TinyTapeout/breakout-pcb/breakout-dip-gf/breakout-dip-gf.kicad_pcb

## KiCad design breakout-dip-gf/breakout-dip-gf.kicad_pcb (2026-09-19)

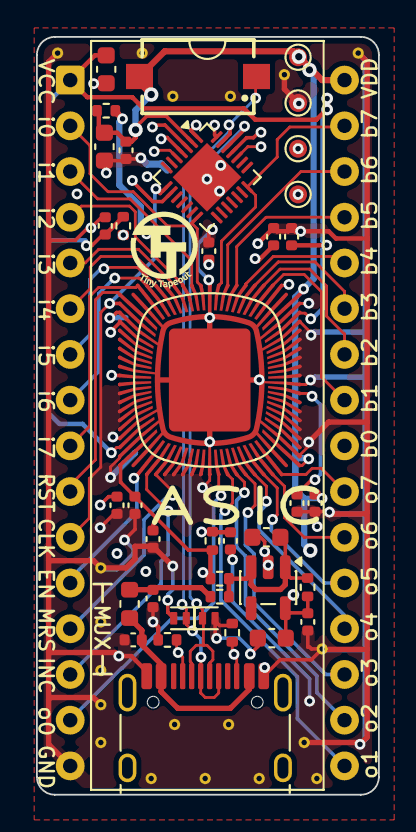
[picture p1: board breakout-dip-gf.kicad_pcb from above]

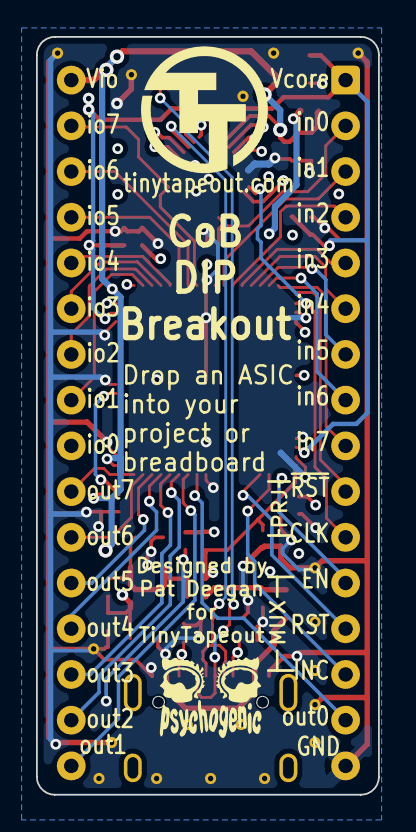
[picture p2: board breakout-dip-gf.kicad_pcb from below]

Board: 4 copper layers, 19.0 x 42.1 mm, 61 parts (2 on the bottom side), 43 nets.

Parts:
C1, C2: 1uF; C_0402_1005Metric
C3: DIP-32_W15.24mm
C4, C5, C17, C19: 10u; C_0603_1608Metric
C6, C14, C15, C16: 100nF; C_0402_1005Metric
C7, C8, C9, C10, C11, C12, C13, C18: 1u; C_0402_1005Metric
D1, D2: 5VTVS; D_SOD-882
FB1: 120R; L_0603_1608Metric
J1: USB_C; USB_C_Receptacle_HRO_TYPE-C-31-M-12
PsyLogo002: PsychoLogoMicroC
R1, R2: 5.1k; R_0402_1005Metric
R3, R4, R5, R6, R7, R8: 0; R_0402_1005Metric
STITCH01, STITCH2, STITCH2#2, STITCH2#3, STITCH2#4, STITCH2#5, STITCH2#6, STITCH2#7, STITCH2#8, STITCH2#9, STITCH2#10, STITCH2#11, STITCH2#12, STITCH2#13, STITCH3, STITCH4, STITCH5, STITCH5#2, STITCH5#3: StitchingVia-0.3mm
SW1: 434121025816
TP1, TP2, TP4, TP5: TestPoint; TestPoint_Pad_D1.0mm
TTLOGO01: TT_PMOD_Logo_5mm
TTLOGO1: TT_logo
U1: TT_GF_COB; ttgf0p2_cob
U2: CH32X035G8U6; WQFN-28-1EP_4x4mm_P0.4mm_EP2.7x2.7mm
U3: AP2112K-3.3; SOT-23-5

Connections:
/CC1: J1.A5 (CC1), R2.1, U2.28 (CC1)
/CC2: J1.B5 (CC2), R1.1, U2.1 (CC2)
/CH32DCK: TP5.1 (1_1), U2.24 (DCK)
/CH32DIO: TP4.1 (1_1), U2.25 (DIO)
/VDIN: C4.1, R3.1, R7.2, R8.2, U3.1 (VIN), U3.3 (EN)
/enable: C3.12, U1.1 (ctrl_ena), U2.3 (PC0)
/increment: C3.14, U1.2 (ctrl_sel_inc), U2.5 (PA0)
/p_clk: C3.11, U1.56 (u_clk), U2.8 (RX2)
/rst_n: C3.13, U1.3 (ctrl_sel_rst_n), U2.4 (PC3)
/uin0: C3.2, U1.47 (ui[0]), U2.14 (PB3)
/uin1: C3.3, U1.48 (ui[1])
/uin2: C3.4, U1.49 (ui[2])
/uin3: C3.5, U1.50 (ui[3])
/uin4: C3.6, U1.51 (ui[4])
/uin5: C3.7, U1.52 (ui[5])
/uin6: C3.8, U1.53 (ui[6])
/uin7: C3.9, U1.54 (ui[7])
/uio0: C3.24, U1.38 (uio[0])
/uio1: C3.25, U1.39 (uio[1])
/uio2: C3.26, U1.40 (uio[2])
/uio3: C3.27, U1.41 (uio[3])
/uio4: C3.28, U1.42 (uio[4])
/uio5: C3.29, U1.43 (uio[5])
/uio6: C3.30, U1.44 (uio[6])
/uio7: C3.31, U1.45 (uio[7]), U2.21 (PB10)
/uout0: C3.15, U1.10 (uo[0])
/uout1: C3.17, U1.11 (uo[1])
/uout2: C3.18, U1.12 (uo[2])
/uout3: C3.19, U1.13 (uo[3])
/uout4: C3.20, U1.14 (uo[4])
/uout5: C3.21, U1.15 (uo[5])
/uout6: C3.22, U1.16 (uo[6])
/uout7: C3.23, U1.17 (uo[7])
/~p_rst: C3.10, U1.55 (u_rst_n), U2.9 (PA4)
GND: C1.2, C2.2, C3.16 (GND), C4.2, C5.2, C6.2, C7.2, C8.2, C9.2, C10.2, C11.2, C12.2, C13.2, C14.2, C15.2, C16.2, C17.2, C18.2, C19.2, D1.2 (A2), D2.2 (A2), J1.A1 (GND), J1.A12 (GND), J1.B1 (GND), J1.B12 (GND), R1.2, R2.2, STITCH01.1, STITCH2.1, STITCH2#2.1, STITCH2#3.1, STITCH2#4.1, STITCH2#5.1, STITCH2#6.1, STITCH2#7.1, STITCH2#8.1, STITCH2#9.1, STITCH2#10.1, STITCH2#11.1, STITCH2#12.1, STITCH2#13.1, STITCH3.1, STITCH4.1, STITCH5.1, STITCH5#2.1, STITCH5#3.1, TP1.1 (1_1), U1.9 (GND_IO), U1.19 (GND_IO), U1.27 (GND_Analog), U1.34 (GND_Core), U1.36 (GND_IO), U1.46 (GND_IO), U1.57 (GND_IO), U1.63 (GND_Analog), U1.71 (GND_Core), U1.73 (GND_IO), U1.75 (SUB), U2.29 (GND), U3.2 (GND)
VAA: C12.1, C13.1, R6.2, U1.26 (VAA_Analog), U1.64 (VAA_Analog)
VBUS: C2.1, FB1.2, R7.1
VBUSRW: C1.1, FB1.1, J1.A4 (VBUS), J1.A9 (VBUS), J1.B4 (VBUS), J1.B9 (VBUS)
VDD_{CORE}: C3.1 (VCORE), C10.1, C11.1, C15.1, C17.1, R4.2, R6.1, U1.35 (VDD_Core), U1.72 (VDD_Core)
VDD_{IO}: C3.32 (VIO), C7.1, C8.1, C9.1, C14.1, C16.1, C18.1, C19.1, R4.1, R5.2, R8.1, SW1.2, TP2.1 (1_1), U1.18 (VDD_IO), U1.37 (VDD_IO), U1.58 (VDD_IO), U1.74 (VDD_IO), U2.2 (VDD)
VIO_{REG}: C5.1, C6.1, R3.2, R5.1, U3.5 (VOUT)
usb_d+: D2.1 (A1), J1.A6 (D+), J1.B6 (D+), SW1.1, U2.27 (UDP)
usb_d-: D1.1 (A1), J1.A7 (D-), J1.B7 (D-), U2.26 (UDM)
