TinyTapeout/breakout-pcb/breakout-sky-qfn/breakout-sky-qfn.kicad_pcb

## KiCad design breakout-sky-qfn/breakout-sky-qfn.kicad_pcb (2025-09-11)

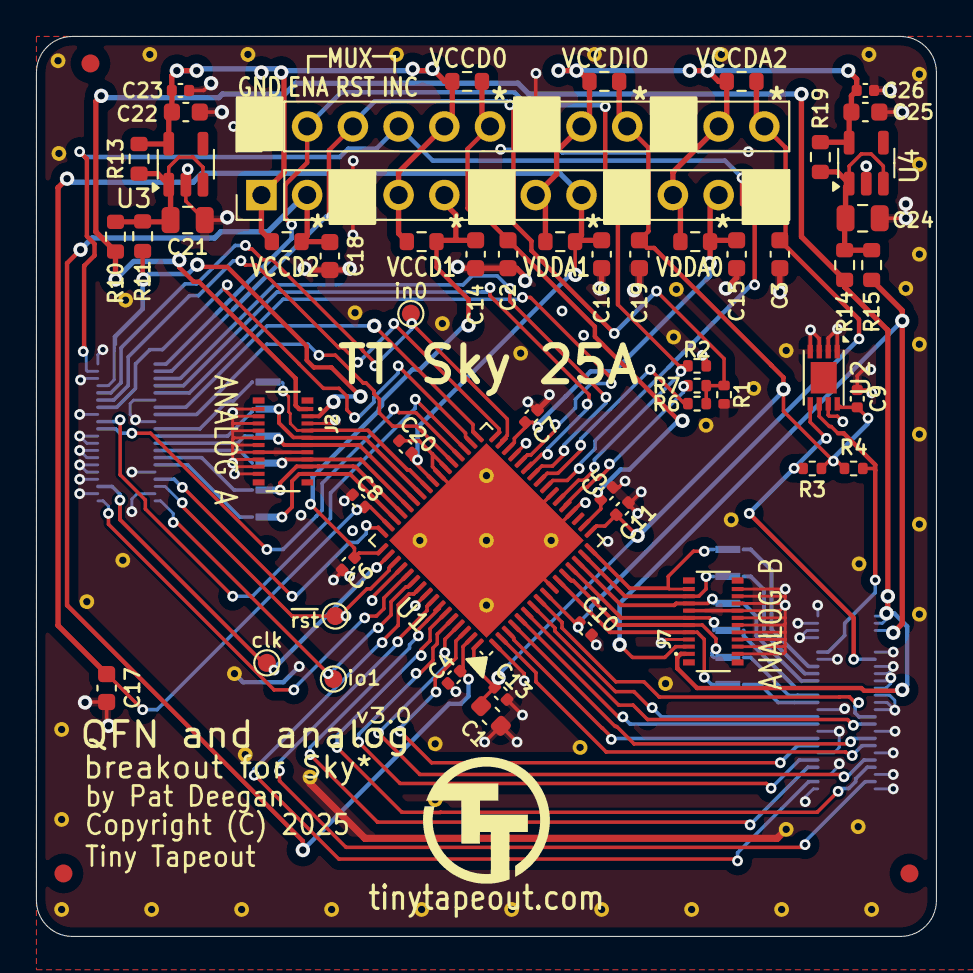
[picture p3: board breakout-sky-qfn.kicad_pcb from above]

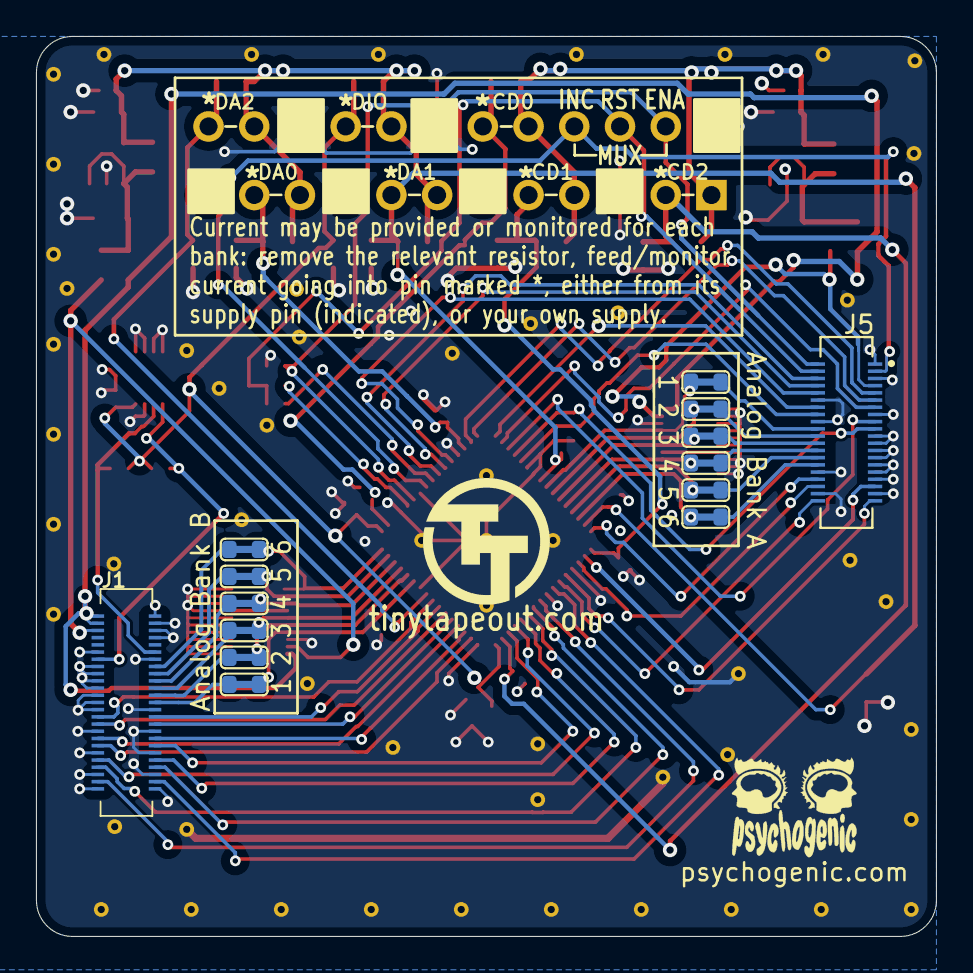
[picture p4: board breakout-sky-qfn.kicad_pcb from below]

Board: 4 copper layers, 50.0 x 50.0 mm, 130 parts (15 on the bottom side), 74 nets.

Parts:
C1, C2, C3, C14, C15, C16, C17, C18, C19: C_1u_0603_50V; C_0603_1608Metric
C4, C5, C6, C7, C8, C9, C10, C11, C13, C20: 0.1uf; C_0402_1005Metric
C21, C24: 10uF; C_0805_2012Metric
C22, C25: 1uF; C_0603_1608Metric
C23, C26: 100nF; C_0402_1005Metric
FID1, FID2, FID3: Fiducial; Fiducial_1mm_Mask2mm
J1: DF40C-50DS-0.4V_51; HRS_DF40C-50DS-0.4V_51
J2, J7: DF40C-20DS-0.4V_51; HRS_DF40C-20DP-0.4V_51
J3, J4: Conn_01x12; PinHeader_1x12_P2.54mm_Vertical
J5: DF40C-40DS-0.4V_51; HIROSE_DF40C-40DS-0.4V_51
JP1, JP2, JP3, JP4, JP5, JP6, JP7, JP8, JP9, JP10, JP11, JP12: Jumper_2_Small_Bridged; SolderJumper-2_0603
R1, R2: 1k; R_0402_1005Metric
R3, R4: 2k; R_0402_1005Metric
R5, R8, R9, R10, R11, R12, R13, R14, R15, R16, R17, R18, R19: 0; R_0603_1608Metric
R6, R7: 0R; R_0402_1005Metric
STITCH01, STITCH01#2, STITCH01#3, STITCH01#4, STITCH01#5, STITCH01#6, STITCH01#7, STITCH01#8, STITCH01#9, STITCH01#10, STITCH01#11, STITCH01#12, STITCH01#13, STITCH01#14, STITCH01#15, STITCH01#16, STITCH01#17, STITCH01#18, STITCH01#19, STITCH01#20, STITCH01#21, STITCH01#22, STITCH01#23, STITCH01#24, STITCH01#25, STITCH01#26, STITCH01#27, STITCH01#28, STITCH01#29, STITCH01#30, STITCH01#31, STITCH01#32, STITCH01#33, STITCH01#34, STITCH01#35, STITCH2, STITCH3, STITCH4, STITCH5, STITCH6, STITCH7, STITCH8, STITCH9, STITCH10, STITCH11, STITCH12, STITCH13, STITCH14, STITCH14#2, STITCH15, STITCH16, STITCH17, STITCH18, STITCH19, STITCH20: StitchingVia-0.4mmDrill
TP5, TP6, TP7, TP8: TestPoint; TestPoint_Pad_D1.0mm
TTLOGO1, TTLOGO1#2: TT_logo
U1: Openframe_QFN_TT06_REV2; QFN-64-1EP_9x9mm_P0.5mm_EP7.65x7.65mm
U2: 24LC02; DFN-8-1EP_3x2mm_P0.5mm_EP1.75x1.45mm
U3, U4: AP2112K-1.8; SOT-23-5

Connections:
+3V3: J1.5, J2.3, J5.8, J7.3, R11.1, R15.1
+5V: J1.1, J1.3, J2.1, J7.1, R10.1, R14.1
/CS_SCL: J1.12, R4.2, U2.6 (SCL)
/RES1: J5.5, U1.26 (reserved)
/RES2: J5.7, U1.27 (reserved)
/RES3: J5.9, U1.28 (reserved)
/RX_SDA: J1.13, R3.2, U2.5 (SDA)
/VCIN: C21.1, R10.2, R11.2, R13.1, U3.1 (VIN), U3.3 (EN)
/VDIN: C24.1, R14.2, R15.2, R19.1, U4.1 (VIN), U4.3 (EN)
/c_ena: J4.2, J5.1, R2.1, U1.22 (ctrl_ena)
/c_rst_n: R6.2, U1.25 (ctrl_sel_rst_n)
/c_sel_inc: J4.4, J5.4, U1.24 (ctrl_sel_inc)
/chip_an0: J2.7, JP1.1 (A), U1.41 (analog[0])
/chip_an1: J2.9, JP2.1 (A), U1.42 (analog[1])
/chip_an2: J2.11, JP3.1 (A), U1.43 (analog[2])
/chip_an3: J2.15, JP4.1 (A), U1.44 (analog[3])
/chip_an4: J2.17, JP5.1 (A), U1.45 (analog[4])
/chip_an5: J2.19, JP6.1 (A), U1.46 (analog[5])
/chip_an6: J7.7, JP7.1 (A), U1.11 (analog[6])
/chip_an7: J7.9, JP8.1 (A), U1.12 (analog[7])
/chip_an8: J7.11, JP9.1 (A), U1.13 (analog[8])
/chip_an9: J7.15, JP10.1 (A), U1.14 (analog[9])
/chip_an10: J7.17, JP11.1 (A), U1.15 (analog[10])
/chip_an11: J7.19, JP12.1 (A), U1.16 (analog[11])
/hd_an0: J5.19, JP1.2 (B)
/hd_an1: J5.21, JP2.2 (B)
/hd_an2: J5.23, JP3.2 (B)
/hd_an3: J5.25, JP4.2 (B)
/hd_an4: J5.27, JP5.2 (B)
/hd_an5: J5.29, JP6.2 (B)
/hd_an6: J1.26, JP7.2 (B)
/hd_an7: J1.24, JP8.2 (B)
/hd_an8: J1.22, JP9.2 (B)
/hd_an9: J1.20, JP10.2 (B)
/hd_an10: J1.18, JP11.2 (B)
/hd_an11: J1.16, JP12.2 (B)
/hd_c_rst_n: J4.3, J5.3, R1.1, R6.1, R7.1
/p_clk: J5.36, TP6.1, U1.50 (clk)
/p_rst: J5.35, TP7.1, U1.51 (rst_n)
/reset_b: R7.2, U1.21 (resetb)
/uin0: J5.10, TP5.1, U1.31 (ui_in[0])
/uin1: J5.12, U1.32 (ui_in[1])
/uin2: J5.13, U1.33 (ui_in[2])
/uin3: J5.14, U1.34 (ui_in[3])
/uin4: J5.18, U1.35 (ui_in[4])
/uin5: J5.20, U1.36 (ui_in[5])
/uin6: J5.15, U1.37 (ui_in[6])
/uin7: J5.33, U1.48 (ui_in[7])
/uio0: J5.40, U1.53 (uio[0])
/uio1: J5.39, TP8.1, U1.54 (uio[1])
/uio2: J1.48, U1.55 (uio[2])
/uio3: J1.47, U1.57 (uio[3])
/uio4: J1.44, U1.58 (uio[4])
/uio5: J1.43, U1.59 (uio[5])
/uio6: J1.42, U1.60 (uio[6])
/uio7: J1.41, U1.61 (uio[7])
/uout0: J1.38, U1.62 (uo_out[0])
/uout1: J1.37, U1.2 (uo_out[1])
/uout2: J1.36, U1.3 (uo_out[2])
/uout3: J1.35, U1.4 (uo_out[3])
/uout4: J1.32, U1.5 (uo_out[4])
/uout5: J1.31, U1.6 (uo_out[5])
/uout6: J1.30, U1.7 (uo_out[6])
/uout7: J1.29, U1.8 (uo_out[7])
GND: C1.2, C2.2, C3.2, C4.1, C5.1, C6.2, C7.1, C8.1, C9.1, C10.2, C11.2, C13.1, C14.2, C15.2, C16.2, C17.2, C18.2, C19.2, C20.1, C21.2, C22.2, C23.2, C24.2, C25.2, C26.2, J1.2, J1.4, J1.6, J1.8, J1.11, J1.14, J1.15, J1.17, J1.19, J1.21, J1.23, J1.25, J1.27, J1.28, J1.33, J1.34, J1.39, J1.40, J1.45, J1.46, J1.49, J1.50, J2.2, J2.4, J2.5, J2.6, J2.8, J2.10, J2.12, J2.13, J2.14, J2.16, J2.18, J2.20, J3.3, J3.6, J3.9, J3.12, J4.1, J4.7, J4.10, J5.2, J5.6, J5.11, J5.16, J5.17, J5.22, J5.24, J5.26, J5.28, J5.30, J5.31, J5.32, J5.34, J5.37, J5.38, J7.2, J7.4, J7.5, J7.6, J7.8, J7.10, J7.12, J7.13, J7.14, J7.16, J7.18, J7.20, R1.2, R2.2, STITCH01.1, STITCH01#2.1, STITCH01#3.1, STITCH01#4.1, STITCH01#5.1, STITCH01#6.1, STITCH01#7.1, STITCH01#8.1, STITCH01#9.1, STITCH01#10.1, STITCH01#11.1, STITCH01#12.1, STITCH01#13.1, STITCH01#14.1, STITCH01#15.1, STITCH01#16.1, STITCH01#17.1, STITCH01#18.1, STITCH01#19.1, STITCH01#20.1, STITCH01#21.1, STITCH01#22.1, STITCH01#23.1, STITCH01#24.1, STITCH01#25.1, STITCH01#26.1, STITCH01#27.1, STITCH01#28.1, STITCH01#29.1, STITCH01#30.1, STITCH01#31.1, STITCH01#32.1, STITCH01#33.1, STITCH01#34.1, STITCH01#35.1, STITCH2.1, STITCH3.1, STITCH4.1, STITCH5.1, STITCH6.1, STITCH7.1, STITCH8.1, STITCH9.1, STITCH10.1, STITCH11.1, STITCH12.1, STITCH13.1, STITCH14.1, STITCH14#2.1, STITCH15.1, STITCH16.1, STITCH17.1, STITCH18.1, STITCH19.1, STITCH20.1, U1.1 (vssa2), U1.10 (vssd2), U1.20 (vssa), U1.23 (vssd), U1.29 (vssio), U1.38 (vssa1), U1.39 (vssd1), U1.52 (vssa1), U1.56 (vssio), U1.65 (ThermalPad), U2.1 (A0), U2.2 (A1), U2.3 (A2), U2.4 (GND), U2.7 (WP), U3.2 (GND), U4.2 (GND)
VCCD_{0}: C2.1, C5.2, J4.6, R16.2, U1.18 (vccd)
VCCD_{1}: C6.1, C14.1, J3.5, R8.2, U1.49 (vccd1)
VCCD_{2}: C4.2, C18.1, J3.2, R5.2, U1.63 (vccd2)
VCC_{REG}: C22.1, C23.1, J3.1, J3.4, J4.5, R5.1, R8.1, R13.2, R16.1, U3.5 (VOUT)
VDDA_{0}: C7.2, C15.1, J3.11, R9.2, U1.30 (vdda)
VDDA_{1}: C8.2, C16.1, C17.1, C20.2, J3.8, R17.2, U1.40 (vdda1), U1.47 (vdda1)
VDDA_{2}: C3.1, C10.1, J4.12, R18.2, U1.9 (vdda2)
VDD_{IO}: C1.1, C9.2, C11.1, C13.2, C19.1, J4.9, R3.1, R4.1, R12.2, U1.17 (vddio), U1.64 (vddio), U2.8 (VCC)
VDD_{REG}: C25.1, C26.1, J3.7, J3.10, J4.8, J4.11, R9.1, R12.1, R17.1, R18.1, R19.2, U4.5 (VOUT)
