TinyTapeout/breakout-pcb/ASIC-simulator/tt04-fpga-ICE40UP5k/breakout-fpga-ICE40UP5K.kicad_pcb

## KiCad design ASIC-simulator/tt04-fpga-ICE40UP5k/breakout-fpga-ICE40UP5K.kicad_pcb (2024-04-16)

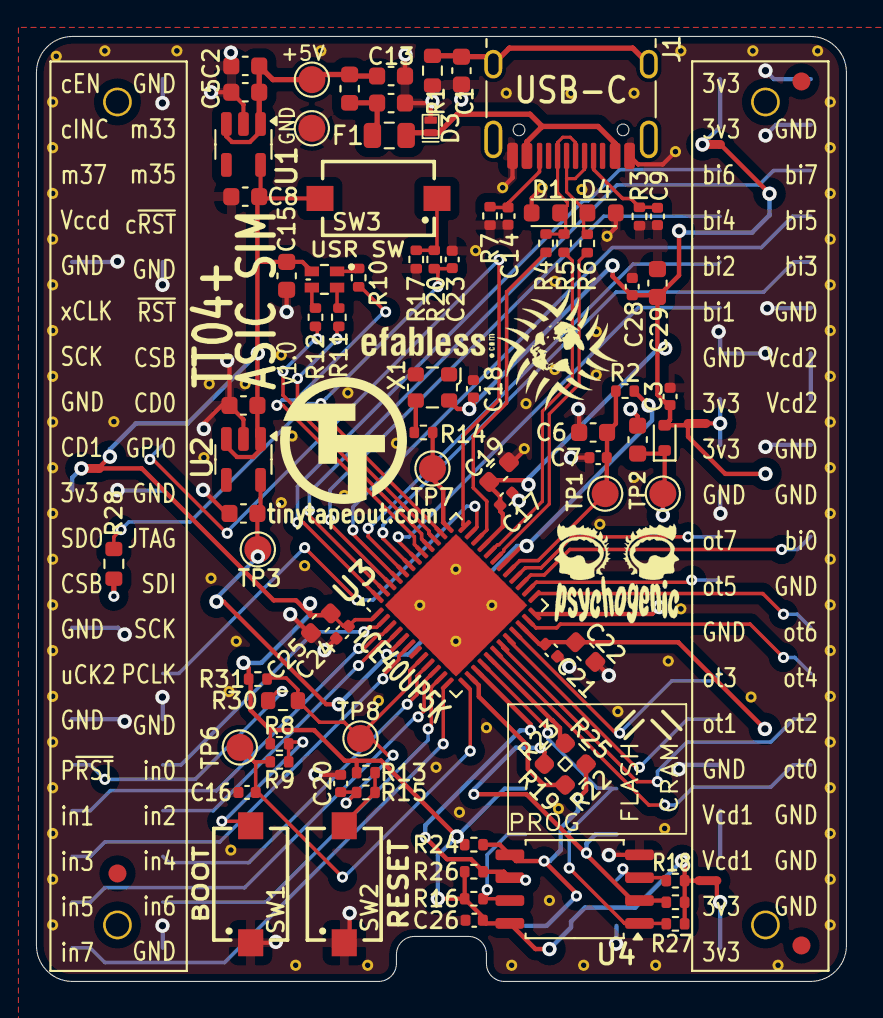
[picture p5: board breakout-fpga-ICE40UP5K.kicad_pcb from above]

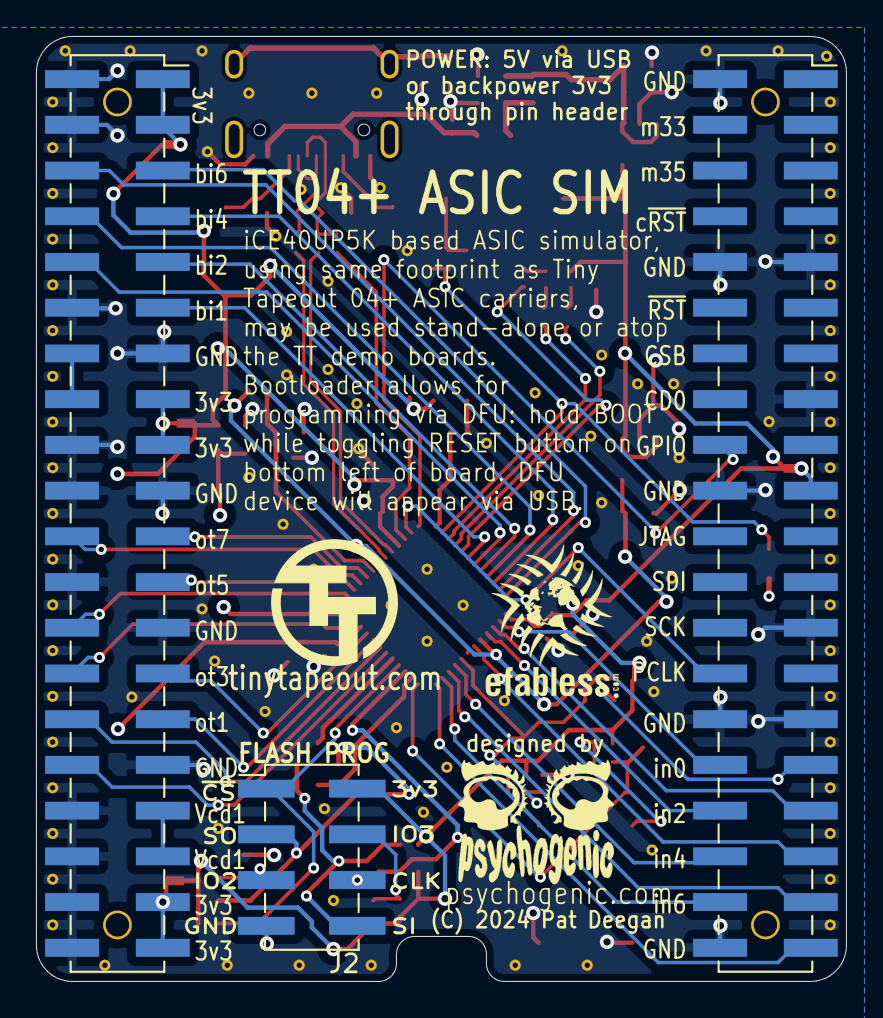
[picture p6: board breakout-fpga-ICE40UP5K.kicad_pcb from below]

Board: 4 copper layers, 45.0 x 52.5 mm, 191 parts (3 on the bottom side), 71 nets.

Parts:
C1: CUSBSHIELD; C_0603_1608Metric
C2, C4, C5, C8, C11, C12, C13: C_1u_0603_50V; C_0603_1608Metric
C3, C7, C16, C17, C18, C20, C21, C23, C24, C26, C28: C_100n_0402_50V; C_0402_1005Metric
C6, C10, C15, C19, C22, C25, C29: C_4p7u_0603_25V; C_0603_1608Metric
C9, C14: C_330p_0402_50V; C_0402_1005Metric
CON1, CON2: FH-00148_PinSocket_2x20_P2.54mm
D1, D4: TVS; D_0603_1608Metric
D2: 1N4448WT; D_SOD-523
D3: VBUSTVS; DFN1006-2
D5: RGB; LED_EAST1616RGBA3
F1: 350mA; Fuse_0805_2012Metric
FB1: 120R; L_0603_1608Metric
FID1, FID2, FID3: Fiducial; Fiducial_1mm_Mask2mm
J1: USB_C; USB_C_Receptacle_HRO_TYPE-C-31-M-12
J2: Conn_02x04_Odd_Even; PinHeader_2x04_P2.54mm_Vertical_SMD
NT1, NT2, NT3, NT4: NetTie_2; NetTie-2_SMD_Pad0.5mm
R1: R_1M_0603; R_0603_1608Metric
R2, R10, R14: R_100R_0402; R_0402_1005Metric
R3, R7: R_5k1_0402; R_0402_1005Metric
R4, R9, R15, R20: R_1k5_0402; R_0402_1005Metric
R5, R6, R11, R12: R_68R_0402; R_0402_1005Metric
R8, R13, R16, R17, R18, R21, R24, R26, R27, R31: R_10k_0402; R_0402_1005Metric
R19, R22, R23, R25, R28, R30: R_0R_0603_JUMPER; R_0603_1608Metric
STITCH1, STITCH1#2, STITCH1#3, STITCH1#4, STITCH1#5, STITCH1#6, STITCH1#7, STITCH1#8, STITCH1#9, STITCH1#10, STITCH1#11, STITCH1#12, STITCH1#13, STITCH1#14, STITCH1#15, STITCH1#16, STITCH1#17, STITCH1#18, STITCH1#19, STITCH1#20, STITCH1#21, STITCH1#22, STITCH1#23, STITCH1#24, STITCH1#25, STITCH1#26, STITCH1#27, STITCH1#28, STITCH1#29, STITCH1#30, STITCH1#31, STITCH1#32, STITCH1#33, STITCH1#34, STITCH1#35, STITCH1#36, STITCH1#37, STITCH1#38, STITCH1#39, STITCH1#40, STITCH1#41, STITCH1#42, STITCH1#43, STITCH1#44, STITCH2, STITCH3, STITCH4, STITCH5, STITCH6, STITCH7, STITCH8, STITCH9, STITCH10, STITCH11, STITCH12, STITCH13, STITCH14, STITCH15, STITCH17, STITCH18, STITCH19, STITCH20, STITCH21, STITCH22, STITCH23, STITCH24, STITCH25, STITCH26, STITCH27, STITCH28, STITCH29, STITCH30, STITCH31, STITCH32, STITCH33, STITCH34, STITCH35, STITCH36, STITCH37, STITCH38, STITCH39, STITCH40, STITCH43, STITCH44, STITCH46, STITCH47, STITCH48, STITCH50, STITCH51, STITCH52, STITCH54, STITCH59, STITCH60, STITCH61, STITCH62, STITCH62#2, STITCH62#3, STITCH62#4, STITCH62#5: StitchingVia-0.3mm
SW1, SW2, SW3: 434121025816
TP1, TP2, TP3, TP4, TP5, TP6, TP7, TP8: TestPoint; TestPoint_Pad_D1.5mm
U1: AP2112K-3.3; SOT-23-5
U2: AP2112K-1.2; SOT-23-5
U3: ICE40UP5K-SG48ITR; QFN-48-1EP_7x7mm_P0.5mm_EP5.6x5.6mm
U4: W25Q32JVSS; SOIC-8_5.23x5.23mm_P1.27mm
X1: 24MHz; Oscillator_SMD_ECS_2520MV-xxx-xx-4Pin_2.5x2.0mm

Connections:
+1V2: C11.1, R2.1, TP3.1, U2.5 (VOUT), U3.5 (VCC), U3.30 (VCC)
+2V5: C10.1, D2.1 (K), TP2.1, U3.24 (VPP_2V5)
+3V3: C3.1, C4.1, C8.1, C15.1, C17.1, C18.1, C19.1, C21.1, C22.1, C24.1, C25.1, C26.1, C28.1, C29.1, D2.2 (A), D5.4, J2.2, NT1.2, NT2.2, NT3.2, NT4.2, R8.1, R13.1, R16.1, R18.1, R21.1, R24.1, R26.1, R27.1, R31.1, SW3.2, U1.5 (VOUT), U2.1 (VIN), U2.3 (EN), U3.1 (VCCIO_2), U3.22 (SPI_VCCIO1), U3.33 (VCCIO_0), U4.8 (VCC), X1.4 (VDD)
+5V: C2.1, C5.1, C13.1, FB1.2, TP4.1, U1.1 (VIN), U1.3 (EN)
/CC1: C9.1, J1.A5 (CC1), R3.1
/CC2: C14.1, J1.B5 (CC2), R7.1
/FL_MISO: J2.3, R19.1, R21.2, R23.1, U4.2 (DO(IO1))
/FL_MOSI: J2.8, R22.2, R24.2, R25.2, U4.5 (DI(IO0))
/FPGA_SI: R23.2, R25.1, U3.17 (IOB_33b_SPI_SI)
/FPGA_SO: R19.2, R22.1, U3.14 (IOB_32a_SPI_SO)
/IOT_44B: R4.1, U3.34 (IOT_44b)
/LED_B: R12.2, U3.40 (RGB1)
/LED_G: R11.2, U3.39 (RGB0)
/LED_R: R10.2, U3.41 (RGB2)
/VCC_PLL: C6.1, C7.1, R2.2, TP1.1, U3.29 (VCCPLL)
/fl_io2: J2.5, R18.2, U4.3 (IO2)
/fl_io3: J2.4, R16.2, U4.7 (IO3)
/oscclk: R14.1, X1.3 (OUT)
/spi_clk: J2.6, R26.2, U3.15 (IOB_34a_SPI_SCK), U4.6 (CLK)
/vbus: D3.1 (K), F1.1, J1.A4 (VBUS), J1.A9 (VBUS), J1.B4 (VBUS), J1.B9 (VBUS)
/vbusfused: C12.1, F1.2, FB1.1
/~FLCS: J2.1, R27.2, U3.16 (IOB_35b_SPI_SS), U4.1 (~CS)
BOOT: C16.1, R9.2, TP6.1, U3.13 (IOB_24a)
GND: C1.2, C2.2, C3.2, C4.2, C5.2, C6.2, C7.2, C8.2, C9.2, C10.2, C11.2, C12.2, C13.2, C14.2, C15.2, C16.2, C17.2, C18.2, C19.2, C20.2, C21.2, C22.2, C23.2, C24.2, C25.2, C26.2, C28.2, C29.2, CON1.2, CON1.9, CON1.10, CON1.15, CON1.20, CON1.25, CON1.29, CON1.30, CON1.40, CON2.2, CON2.4, CON2.12, CON2.13, CON2.18, CON2.19, CON2.20, CON2.24, CON2.25, CON2.31, CON2.34, CON2.36, CON2.38, CON2.40, D1.2 (A2), D3.2 (A), D4.2 (A2), J1.A1 (GND), J1.A12 (GND), J1.B1 (GND), J1.B12 (GND), J2.7, R1.2, R3.2, R7.2, R17.2, STITCH1.1, STITCH1#2.1, STITCH1#3.1, STITCH1#4.1, STITCH1#5.1, STITCH1#6.1, STITCH1#7.1, STITCH1#8.1, STITCH1#9.1, STITCH1#10.1, STITCH1#11.1, STITCH1#12.1, STITCH1#13.1, STITCH1#14.1, STITCH1#15.1, STITCH1#16.1, STITCH1#17.1, STITCH1#18.1, STITCH1#19.1, STITCH1#20.1, STITCH1#21.1, STITCH1#22.1, STITCH1#23.1, STITCH1#24.1, STITCH1#25.1, STITCH1#26.1, STITCH1#27.1, STITCH1#28.1, STITCH1#29.1, STITCH1#30.1, STITCH1#31.1, STITCH1#32.1, STITCH1#33.1, STITCH1#34.1, STITCH1#35.1, STITCH1#36.1, STITCH1#37.1, STITCH1#38.1, STITCH1#39.1, STITCH1#40.1, STITCH1#41.1, STITCH1#42.1, STITCH1#43.1, STITCH1#44.1, STITCH2.1, STITCH3.1, STITCH4.1, STITCH5.1, STITCH6.1, STITCH7.1, STITCH8.1, STITCH9.1, STITCH10.1, STITCH11.1, STITCH12.1, STITCH13.1, STITCH14.1, STITCH15.1, STITCH17.1, STITCH18.1, STITCH19.1, STITCH20.1, STITCH21.1, STITCH22.1, STITCH23.1, STITCH24.1, STITCH25.1, STITCH26.1, STITCH27.1, STITCH28.1, STITCH29.1, STITCH30.1, STITCH31.1, STITCH32.1, STITCH33.1, STITCH34.1, STITCH35.1, STITCH36.1, STITCH37.1, STITCH38.1, STITCH39.1, STITCH40.1, STITCH43.1, STITCH44.1, STITCH46.1, STITCH47.1, STITCH48.1, STITCH50.1, STITCH51.1, STITCH52.1, STITCH54.1, STITCH59.1, STITCH60.1, STITCH61.1, STITCH62.1, STITCH62#2.1, STITCH62#3.1, STITCH62#4.1, STITCH62#5.1, SW1.1, SW2.1, TP5.1, U1.2 (GND), U2.2 (GND), U3.49 (GND), U4.4 (GND), X1.2 (GND)
unnamed: D5.1, R10.1
unnamed: D5.2, R11.1
unnamed: D5.3, R12.1
unnamed: C1.1, J1.S1 (SHIELD), R1.1
unnamed: R8.2, R9.1, SW1.2
unnamed: R13.2, R15.1, SW2.2
unnamed: R17.1, R20.1, SW3.1
USB_D+: D1.1 (A1), J1.A6 (D+), J1.B6 (D+), R4.2, R5.1
USB_D-: D4.1 (A1), J1.A7 (D-), J1.B7 (D-), R6.1
USB_DN: R6.2, U3.31 (IOT_42b)
USB_DP: R5.2, U3.32 (IOT_43a)
clk/mio[6]: CON1.28, U3.35 (IOT_46b_G0)
gpio: CON1.18, U3.36 (IOT_48b)
sys_clk: R14.2, TP7.1, U3.37 (IOT_45a_G1)
ui_in[0]/mio[8]: CON1.32, U3.2 (IOB_6a)
ui_in[1]/mio[9]: CON1.33, U3.3 (IOB_9b)
ui_in[2]/mio[10]: CON1.34, U3.4 (IOB_8a)
ui_in[3]/mio[11]: CON1.35, U3.6 (IOB_13b)
ui_in[4]/mio[12]: CON1.36, U3.9 (IOB_16a)
ui_in[5]/mio[13]: CON1.37, U3.10 (IOB_18a)
ui_in[6]/mio[14]: CON1.38, U3.11 (IOB_20a)
ui_in[7]/mio[15]: CON1.39, U3.12 (IOB_22a)
uio[0]/mio[24]: CON2.22, U3.27 (IOT_38b)
uio[1]/mio[25]: CON2.11, U3.42 (IOT_51a)
uio[2]/mio[26]: CON2.9, U3.44 (IOB_3b_G6)
uio[3]/mio[27]: CON2.10, U3.43 (IOT_49a)
uio[4]/mio[28]: CON2.7, U3.46 (IOB_0a)
uio[5]/mio[29]: CON2.8, U3.45 (IOB_5b)
uio[6]/mio[30]: CON2.5, U3.48 (IOB_4a)
uio[7]/mio[31]: CON2.6, U3.47 (IOB_2a)
uo_out[0]/mio[16]: CON2.32, U3.18 (IOB_31b)
uo_out[1]/mio[17]: CON2.29, U3.20 (IOB_25b_G3)
uo_out[2]/mio[18]: CON2.30, U3.19 (IOB_29b)
uo_out[3]/mio[19]: CON2.27, U3.21 (IOB_23b)
uo_out[4]/mio[20]: CON2.28, U3.23 (IOT_37a)
uo_out[5]/mio[21]: CON2.23, U3.26 (IOT_39a)
uo_out[6]/mio[22]: CON2.26, U3.25 (IOT_36b)
uo_out[7]/mio[23]: CON2.21, U3.28 (IOT_41a)
usr_sw1: C23.1, R20.2, R28.2, U3.38 (IOT_50b)
vccd1: CON2.33, CON2.35
vccd2: CON2.14, CON2.16
vdda: CON1.19, NT1.1
vdda1: CON2.37, CON2.39, NT2.1
vdda2: CON2.1, CON2.3, NT3.1
vddio: CON2.15, CON2.17, NT4.1
~CRESET: C20.1, R15.2, R30.2, R31.2, TP8.1, U3.8 (~CRESET)
~rst/mio[7]: CON1.31, R28.1, R30.1
