TinyTapeout/breakout-pcb/(notices)

Notices in the files:
breakout-qfn/breakout-tt07-qfn.kicad_pcb:
(C) 2024 Pat Deegan
Copyright (C) 2024 Tiny Tapeout
breakout-qfn/breakout-qfn.kicad_pcb:
(C) 2025 Pat Deegan
Copyright (C) 2025 Tiny Tapeout
breakout-tt04-qfn-socket/breakout-tt04-qfn-socket.kicad_pcb:
(C) 2023, 2024 Pat Deegan
breakout-qfn/breakout-qfn.kicad_sch:
(C) 2024-2025 Pat Deegan
breakout-ihp-qfn/breakout-ihp-qfn.kicad_pcb:
(C) 2026 Pat Deegan
Copyright (C) 2026
